L1AMcB/ECE445SeniorDesign/LabNotebooks/Alex/2025-03-03-emap.md

---
layout: post
title:  "Update - Breadboard Planning"
date:   2025-03-03
author: Alex
categories: emap
dev_blog: true
---

&nbsp;&nbsp;&nbsp;&nbsp;Today we ordered our force sensor, called *FlexiForce*. It is a resistive force sensor that can measure up to 100lbs. A kick in Taekwondo far exceeds 100lbs, but we will implement various mechanisms to tone down the measured force and amplify it back up to the true force. 

&nbsp;&nbsp;&nbsp;&nbsp;We also planned out what to showcase for our breadboard demonstration coming up in a week. We will use the STM devboard to test out the functionality and the practicality of our FlexiForce sensors. 

<figure>
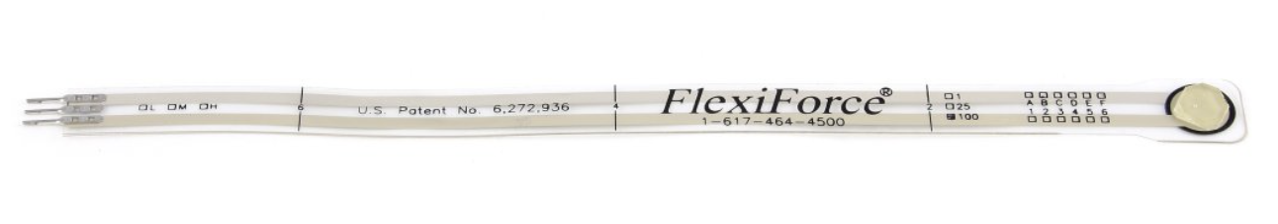
[picture p19: LabNotebooks/Alex/images_archive/projects/emap/flexiforceimg.png]
flexiforce
    
    <figcaption>8″ FlexiForce</figcaption>
</figure>
