L1AMcB/ECE445SeniorDesign/LabNotebooks/Alex/2025-04-12-emap.md

---
layout: post
title:  "Update - ESP32 bare minimum setup"
date:   2025-04-12
author: Alex
categories: emap
dev_blog: true
---

&nbsp;&nbsp;&nbsp;&nbsp; Today we got the bare minimum circuit working on our PCB. While we waited for the rest of our components, we made sure our ESP32 is able to connect to our computer. We also ensured that the program we developed is able to recongize the ESP32. 

&nbsp;&nbsp;&nbsp;&nbsp; We were also now able to figure out the bluetooth connectivity of the ESP32 to our computer. So far, we've been testing with the Scopy's built-in voltage supply using the ADALM2000.
