L1AMcB/ECE445SeniorDesign/block_diagram.png

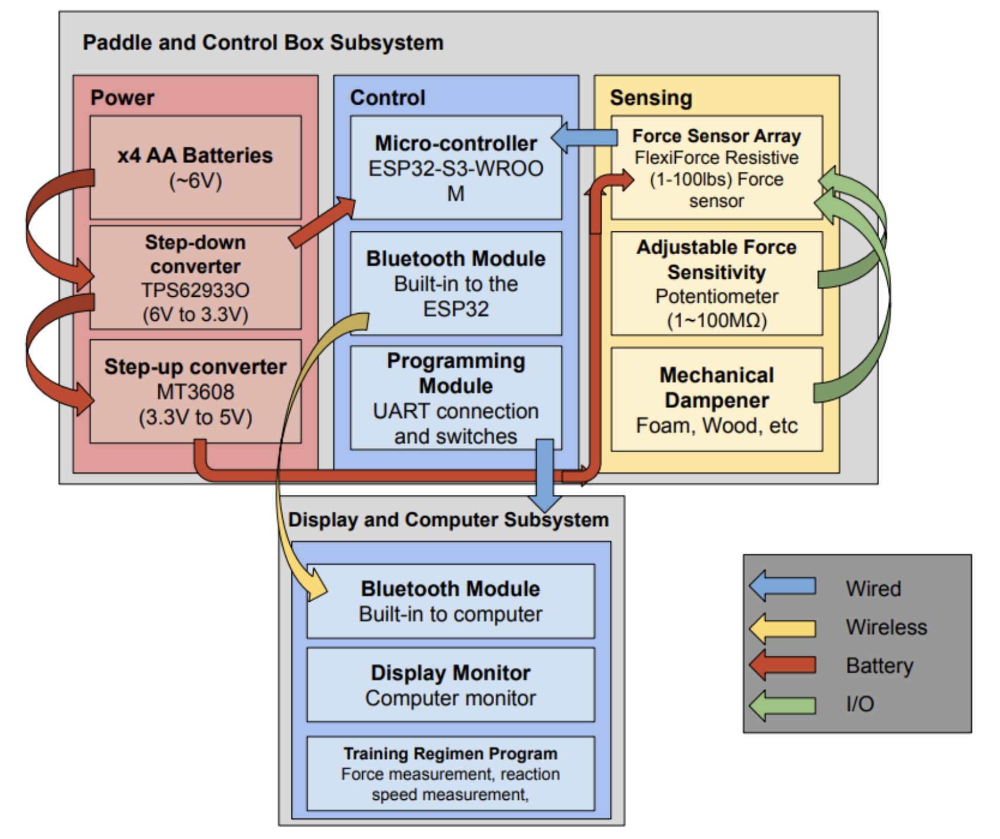
block_diagram.png
