L1AMcB/ECE445SeniorDesign/ECE445Program/assets/homescreen.png

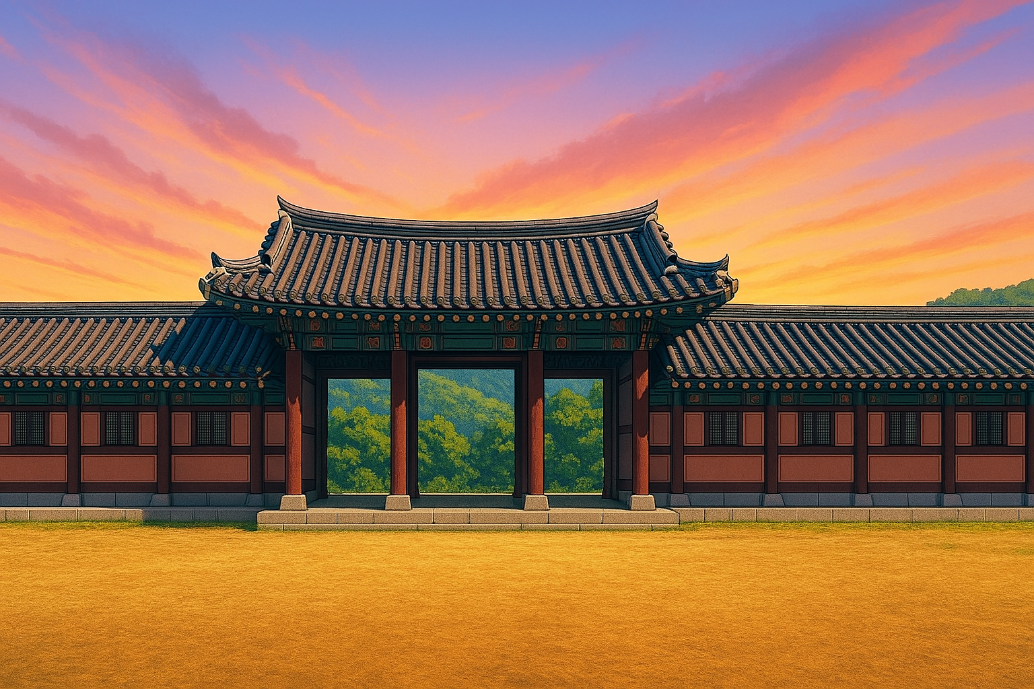
ECE445Program/assets/homescreen.png
