L1AMcB/ECE445SeniorDesign/sensor_general.png

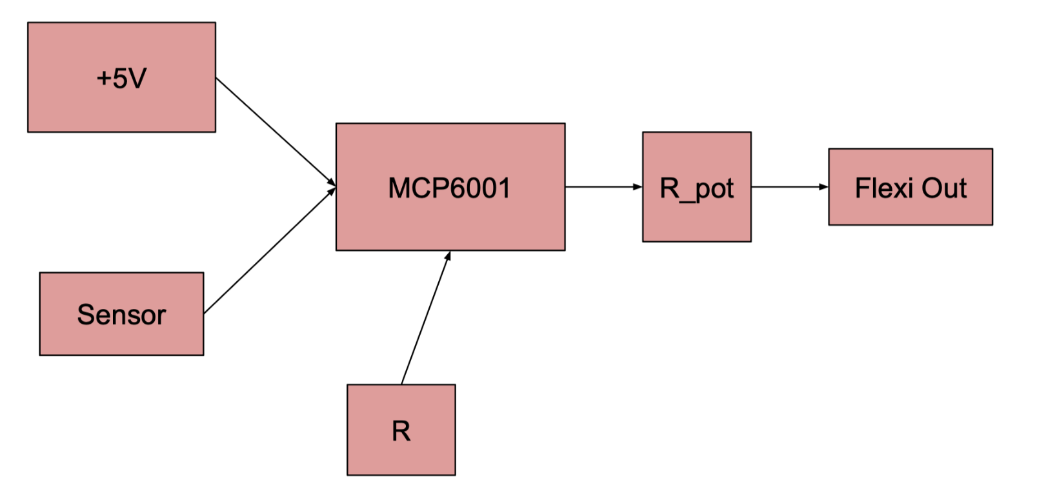
sensor_general.png
